d3rail0/ArduinoVFOTuner/images/centronics_pins - copy.png

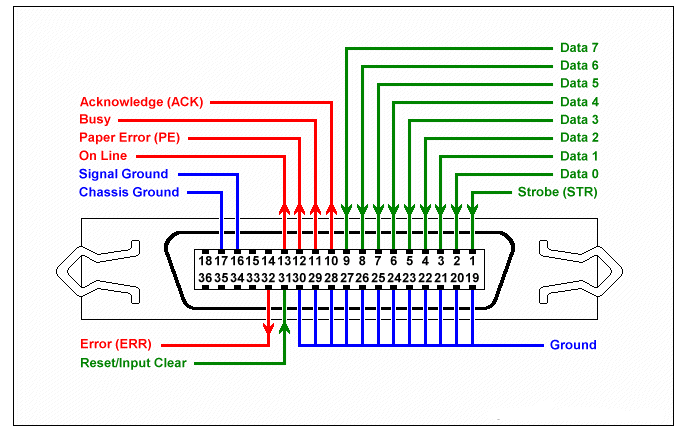
images/centronics_pins - copy.png
