d3rail0/ArduinoVFOTuner/images/re20p.jpg

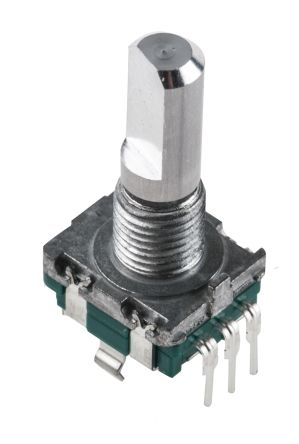
images/re20p.jpg
