d3rail0/ArduinoVFOTuner/(commit log)

2022-02-07 Fixed issue with incorrect bit order, missing 4*n bit shifts when frequency is ending with n zeros and two MSB bits are now shifted to the right for 10 MHz frequency changes
    [VFOTuner.ino, bconverter.cpp]
2022-03-09 Optimization: Update frequency only when encoder turns
